Hau381/DC_Motor_Speed_And_Position_Control/baocao.pdf

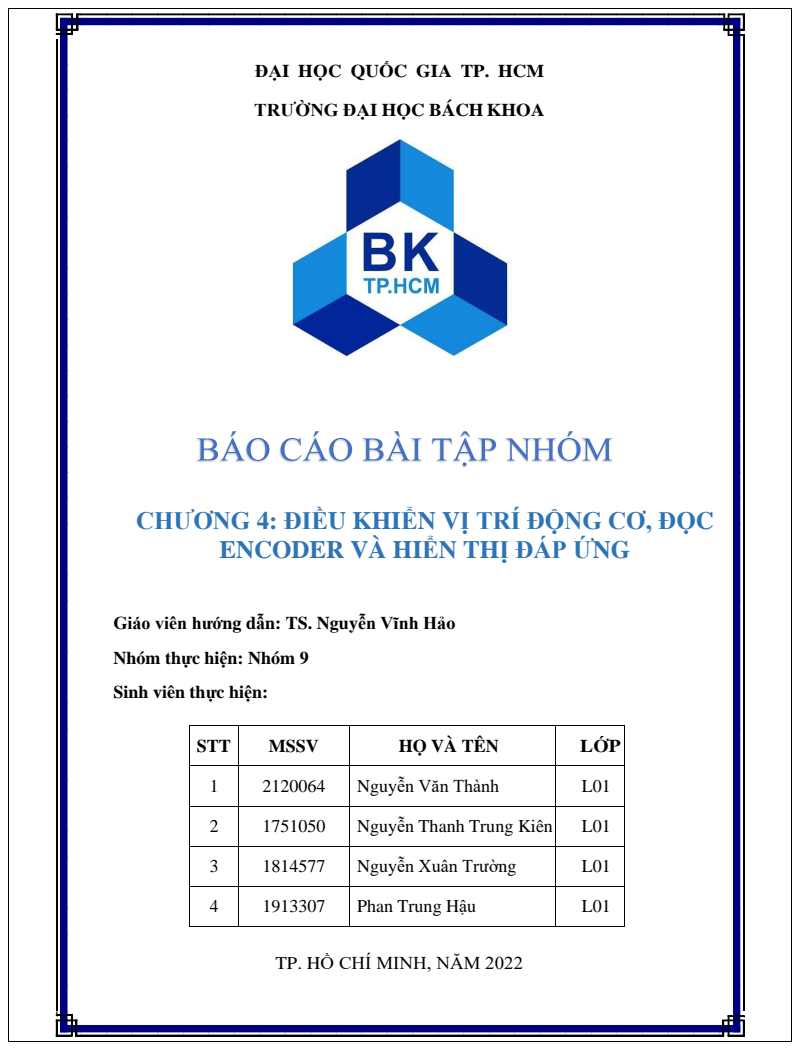
[picture p1: page 1]

ĐẠI HỌC QUỐC GIA TP. HCM

TRƯỜNG ĐẠI HỌC BÁCH KHOA

CHƯƠNG 4: ĐIỀU KHIỂN VỊ TRÍ ĐỘNG CƠ, ĐỌC

ENCODER VÀ HIỂN THỊ ĐÁP ỨNG

Giáo viên hướng dẫn: TS. Nguyễn Vĩnh Hảo

Nhóm thực hiện: Nhóm 9

Sinh viên thực hiện:

STT | MSSV | HỌ VÀ TÊN | LỚP

1 | 2120064 | Nguyễn Văn Thành | L01

2 | 1751050 | Nguyễn Thanh Trung Kiên | L01

3 | 1814577 | Nguyễn Xuân Trường | L01

4 | 1913307 | Phan Trung Hậu | L01

TP. HỒ CHÍ MINH, NĂM 2022

# Mục lục

### I. CHUẨN BỊ THIẾT BỊ VÀ LINH KIỆN

### 1.1 Động cơ Servo GM25 – 370 DC Geared Motor:

- Động Cơ DC Servo GM25-370 DC Geared Motor được tích hợp thêm Encoder hai kênh AB giúp đọc và điều kiển chính xác vị trí, chiều quay của động cơ trong các

ứng dụng cần độ có chính xác cao: điều khiển PID, Robot tự hành,....

- Động Cơ DC Servo GM25-370 DC Geared Motor có cấu tạo bằng kim loại cho độ

bền và độ ổn định cao, được sử dụng trong các mô hình robot, xe, thuyền,..., hộp

giảm tốc của động cơ có nhiều tỉ số truyền giúp bạn dễ dàng lựa chọn giữa lực kéo

và tốc độ (lực kéo càng lớn thì tốc độ càng chậm và ngược lại), động cơ sử dụng

nguyên liệu chất lượng cao.

- Thông số kỹ thuật:
- Điện áp sử dụng: 12VDC
- Đường kính: 25mm
- Encoder: Cảm biến từ trường Hall, có 2 kênh AB lệch nhau giúp xác định chiều

quay và vận tốc của động cơ, đĩa Encoder trả ra 11 xung/1 kênh/ 1 vòng (nếu đo

tín hiệu đồng thời của cả hai kênh sẽ thu được tổng 22 xung / 1 vòng quay của

Encoder).
- Cách tính số xung của mỗi kênh trên 1 vòng quay của trục chính động cơ = Tỉ số

truyền x số xung của Encoder, ví dụ tỉ số 150:1 thì số xung Encoder trả ra cho 1

vòng quay của trục chính động cơ sẽ là 11 x 150 = 1650 xung / 1 kênh.
- Điện áp cấp cho Encoder hoạt động: 3.3~5VDC, lưu ý cấp quá áp hoặc ngược chiều

sẽ làm cháy Encoder ngay lập tức!

Nhóm sử dụng Loại 12VDC 250RPM:
- Tỉ số truyền 34:1 (động cơ quay 34 vòng trục chính hộp giảm tốc quay 1

vòng).

- Dòng không tải: 150mA
- Dòng chịu đựng tối đa khi có tải: 750mA
- Tốc độ không tải: 250RPM (250 vòng 1 phút)
- Tốc độ chịu đựng tối đa khi có tải: 140RPM (140 vòng 1 phút)

- Lực kéo Moment định mức: 4.3KG.CM
- Lực léo Moment tối đa: 5.2KG.CM
- Chiều dài hộp số L: 21mm
- Số xung Encoder mỗi kênh trên 1 vòng quay trục chính: 11 x 34 = 374 xung.
- Sơ đồ chân của động cơ:
- M1 : Dây cấp nguồn cho động cơ.
- GND : Dây cấp nguồn cho Encoder, 0VDC.
- C1/A: Kênh trả xung A
- C2/B: Kênh trả xung B
- VCC: Dây cấp nguồn cho Encoder 3.3~5VDC
- M2: Dây cấp nguồn cho động cơ

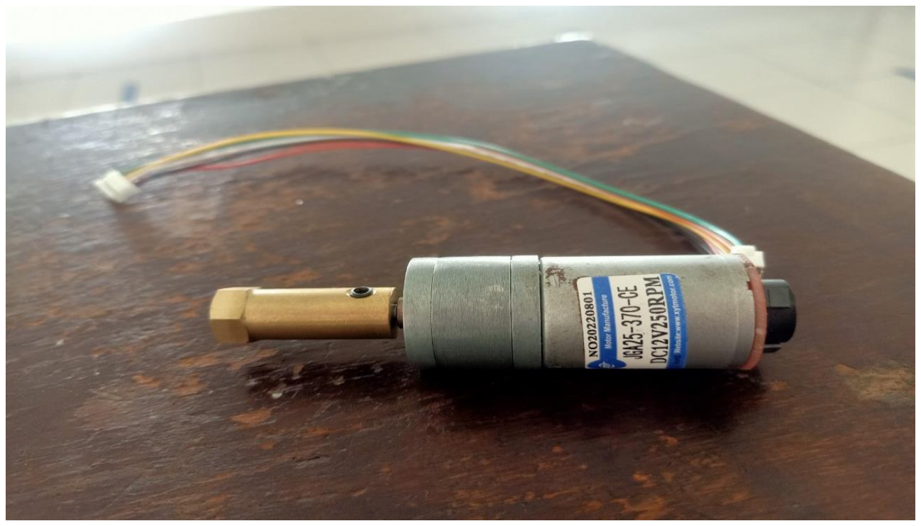
[picture p2: figure]

Hình 1: Động cơ 12VDC 250RPM

### 1.2 L298 DC Motor Driver

Module điều khiển motor L298N loại 1 có sẵn ốc gắn sử dụng IC điều khiển L298N có thể

điều khiển 2 động cơ một chiều hoặc 1 động cơ bước 4 pha.

Module L298N loại 1:

+ Được thiết kế chắc chắn, có sẵn chỗ bắt ốc vào mô hình

+ Có gắn tản nhiệt chống nóng cho IC, giúp IC có thể điều khiển với dòng đỉnh đạt 2A.

IC L298N được gắn với các đi ốt trên board giúp bảo vệ vi xử lý chống lại các dòng điện

cảm ứng từ việc khởi động/ tắt động cơ.

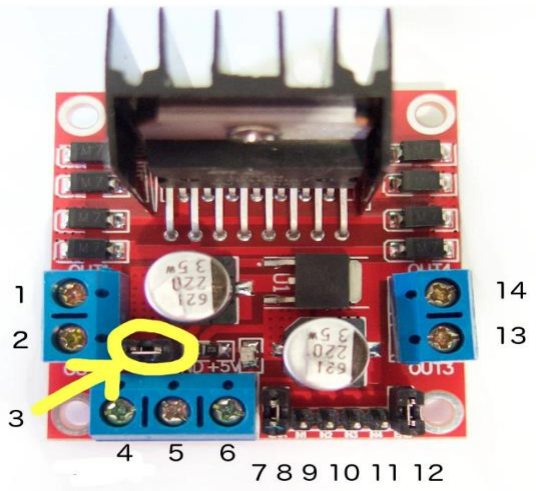
[picture p3: figure]

Hình 2: L298 DC Motor Driver

- Sơ đồ chân L298 DC Motor Driver
1. DC motor 1 “+” hoặc stepper motor A+
2. DC motor 1 “-” hoặc stepper motor A-
3. 12V jumper – tháo jumper ra nếu sử dụng nguồn trên 12V. Jumper này dùng để

cấp nguồn cho IC ổn áp tạo ra nguồn 5V nếu nguồn trên 12V sẽ làm cháy IC

Nguồn

4. Cắm dây nguồn cung cấp điện áp cho motor vào đây từ 6V đến 35V.
5. Cắm chân GND của nguồn vào đây
6. Ngõ ra nguồn 5V, nếu jumper đầu vào không rút ra.
7. Chân Enable của Motor 1, chân này dùng để cấp xung PWM cho motor nếu

dùng VDK thì rút jumper ra và cắm chân PWM vào đây. Giữ nguyên khi dùng với

động cơ bước

8. IN1
9. IN2
10. IN3
11. IN4
12. Chân Enable của Motor 2, chân này dùng để cấp xung PWM cho motor nếu

dùng VDK thì rút jumper ra và cắm chân PWM vào đây. Giữ nguyên khi dùng với

động cơ bước

13. DC motor 2 “+” hoặc stepper motor B+
14. DC motor 2 “-” hoặc stepper motor B-

### 1.3 Nguồn Adapter 12VDC 2A

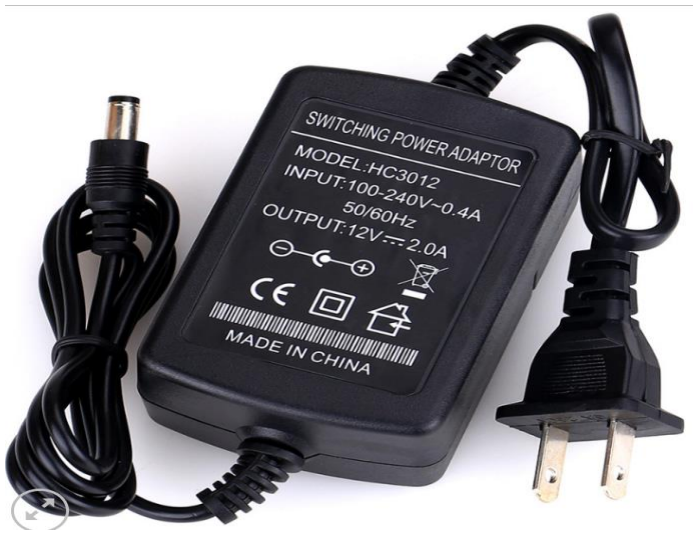
[picture p4: figure]

Hình 3 Nguồn Adapter 12VDC 2A

Thông số kỹ thuật

- Điện áp đầu vào: AC100-240V 50/60HZ
- Đầu cắm AC
- Điện áp ra: 12VDC
- Dòng điện ra: Max 2A
- Chiều dài đường dây đầu ra: tổng chiều dài 1m
- Ổ cắm DC: 5.5 * 2.5mm (tương thích 5.5 * 2.1mm)
- Trọng lượng: 92g

### 1.4 USB Uart CH340

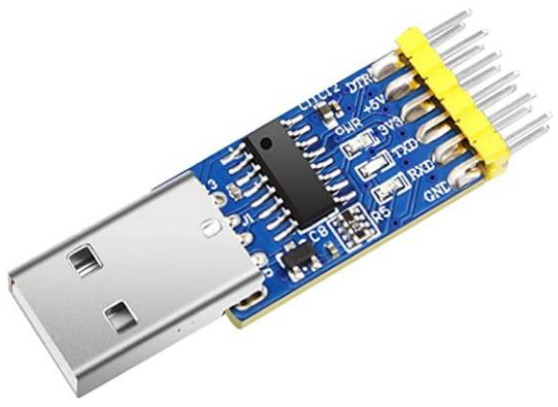
[picture p5: figure]

Hình 4: USB Uart CH340

Thông số kỹ thuật:

- Sử dụng điện áp 5VDC cấp trực tiếp từ cổng USB.
- Các chân tín hiệu ngõ ra:
- 5V: Chân cấp nguồn 5VDC từ cổng USB, tối đa 500mA.
- VCC: chân chọn mức tín hiệu TTL cho TX/RX, nếu nối với chân 5V sẽ là 5VDC,

nối với 3V3 sẽ là 3.3VDC.

- 3V3:Chân nguồn 3.3VDC (dòng cấp rất nhỏ tối đa 100mA), không sử dụng để cấp

nguồn, thường chỉ sử dụng để thiết đặt mức tín hiệu Logic.

- TXD: chân truyền dữ liệu UART TTL, dùng kết nối đến chân nhận RX của các

module sử dụng mức tín hiệu TTL.
- RXD: chân nhận dữ liệu UART TTL, dùng kết nối đến chân nhận TX của các

module sử dụng mức tín hiệu TTL.
- GND: chân cấp nguồn 0VDC.
- Tích hợp led tín hiệu TX, RX.
- Tương thích với hầu hết các hệ điều hành hiện nay: Windows, Mac, Linux.

### 1.5 Kit STM32F407

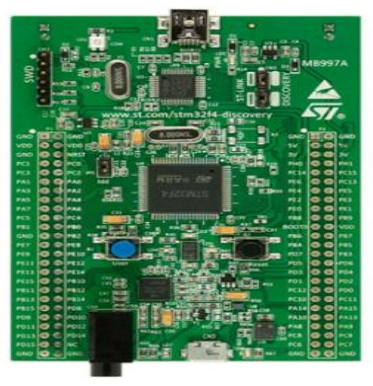
[picture p6: figure]

Hình 5: Kit STM32F407

- Kit STM32F407 Discovery hiện là loại kit được rất nhiều trường đại học hiện nay

sử dụng trong giảng dạy vi điều khiển ARM, nếu so sánh về ngoại vi và sức mạnh

của STM32 so với các dòng ARM của các hãng khác thì ở cùng 1 tầm giá, ARM

của ST vượt trội về cấu hình và ngoại vi hơn rất nhiều.

Thông số kỹ thuật:

- Vi điều khiển chính: STM32F407VGT6 microcontroller featuring 32-bit ARM

Cortex-M4F core, 1 MB Flash, 192 KB RAM in an LQFP100 package.
- Tích hợp sẵn mạch nạp và Debug ST-LINK/V2 with selection mode switch to use

the kit as a standalone ST-LINK/V2 (with SWD connector for programming and

debugging).
- Nguồn cấp từ cổng Mini USB qua các IC nguồn chuyển thành 3v3 để cấp cho MCU.
- Có sẵn các chân nguồn: 3 V and 5 V.

- Có sẵn cảm biến gia tốc: LIS302DL, ST MEMS motion sensor, 3-axis
- Có sẵn bộ xử lý âm thanh: MP45DT02, ST MEMS audio sensor, omni-directional

digital microphone.
- Có sẵn bộ: CS43L22, audio DAC with integrated class D speaker driver.
- Có sẵn 8 Led.
- Có Led thông báo trạng thái nguồn
- Có nút nhấn và nút Reset tích hợp.
- Có cổng Micro USB OTG
- DSP Application.

### II. SƠ ĐỒ KẾT NỐI CHÂN VÀ NGUYÊN LÝ HOẠT ĐỘNG

### 2.1 Sơ đồ kết nối chân

- Nhóm sử dụng phần mềm Altium Designer để thiết kế mạch Schematic và vẽ

mạch in PCB để làm mạch phần cứng.

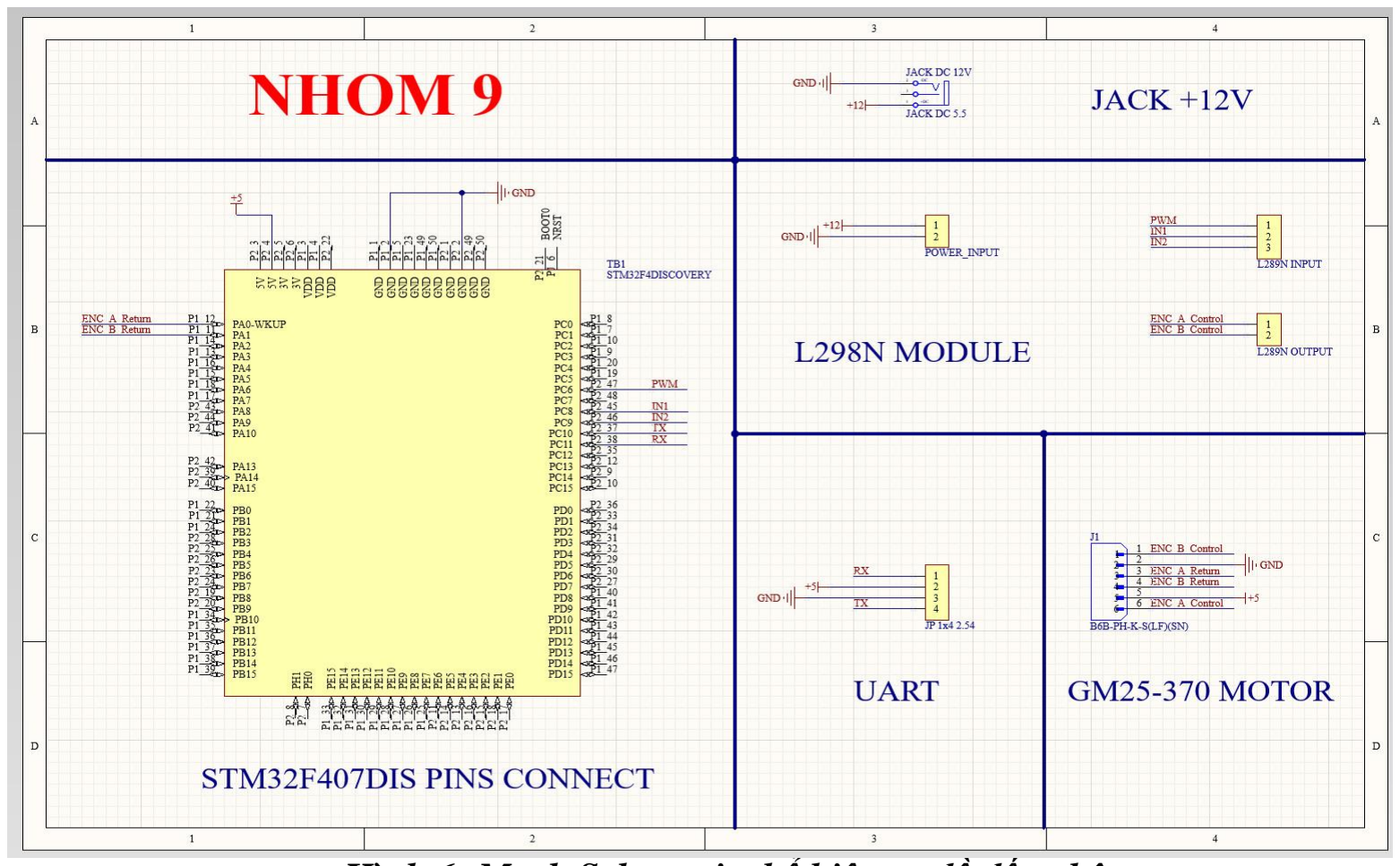
[picture p7: figure]

Hình 6: Mạch Schematic thể hiện sơ đồ đấu chân

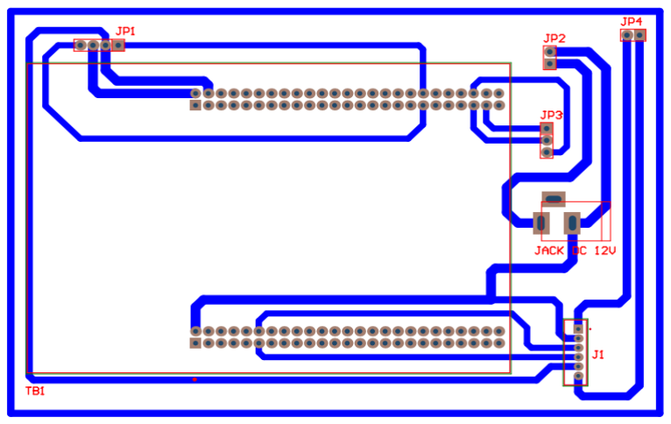
[picture p8: figure]

Hình 7: Mạch in PCB

Qúa trình chọn chân đấu nối:

- Đọc encoder sử dụng port A:

+PA0: ENC A

+ PA1: ENC B
- Giao tiếp UART: Sử dụng port C giao tiếp UART4:

+PC10: UART TX

+PC11: UART RX
- Điều rộng xung PWM và quy định chiều quay motor:

+ PC6: PWM

+PC8: IN1

+PC9: IN2

### 2.2 Nguyên lý hoạt động

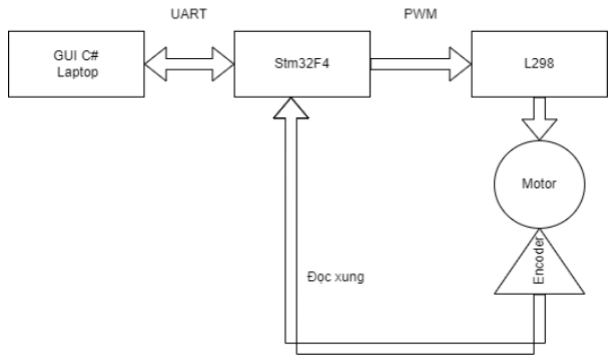
[picture p9: figure]

Hình 8: Sơ đồ nguyên lý

+ Nhóm sẽ viết dao diện bằng C# để đọc và xuất UART và vẽ đáp ứng hiện thị vị trí động cơ

dưới dạng góc quay.

+ STM32F4: đọc xung encoder 2 kênh A,B theo 2 mode là X1 và X4. Điều rộng xung PWM để

điều khiển động cơ.

+ L298 điểu khiển động cơ thông qua việc thay đổi điện áp cấp vào động cơ qua 2 chân out1 và

out2.

+ Motor hoạt động: trục chính motor quay được bao nhiêu vòng thì sẽ xuất được bấy nhiêu xung

ENC A và ENC B ( với 1 vòng là 374 xung). Rồi trả xung về Stm32f4 để đọc xung theo mode

đã chọn và hiển thị đáp ứng lên giao diện C# đã tạo.

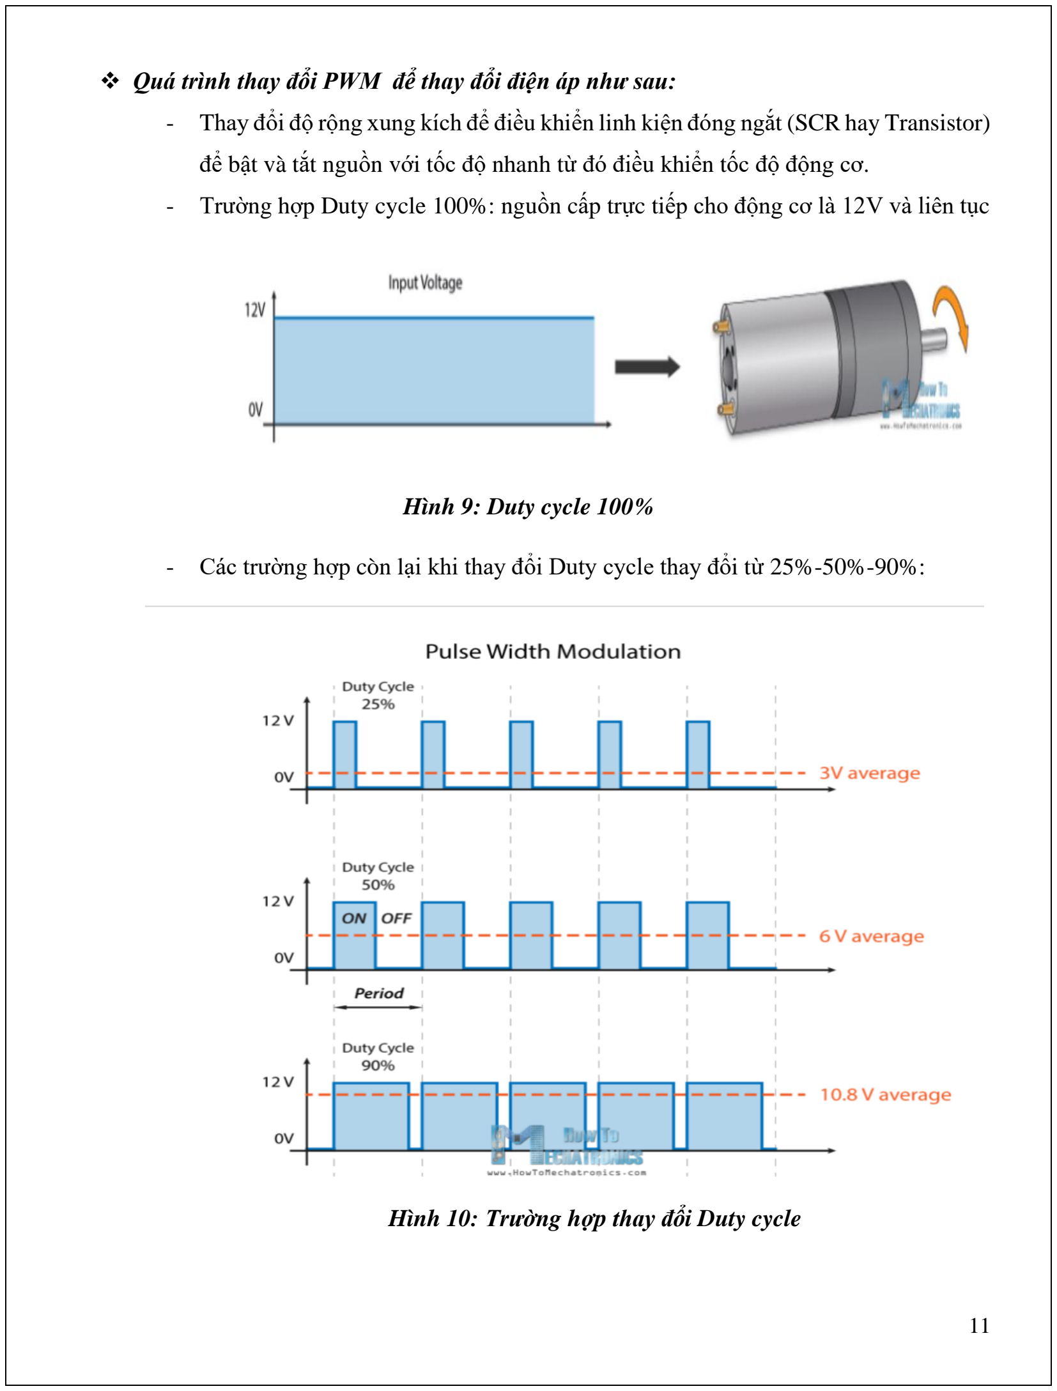
[picture p10: page 13]

❖ Quá trình thay đổi PWM để thay đổi điện áp như sau:

- Thay đổi độ rộng xung kích để điều khiển linh kiện đóng ngắt (SCR hay Transistor)

để bật và tắt nguồn với tốc độ nhanh từ đó điều khiển tốc độ động cơ.

- Trường hợp Duty cycle 100%: nguồn cấp trực tiếp cho động cơ là 12V và liên tục

Hình 9: Duty cycle 100%

- Các trường hợp còn lại khi thay đổi Duty cycle thay đổi từ 25%-50%-90%:

Hình 10: Trường hợp thay đổi Duty cycle

- Khi Duty cycle càng lớn thì điện áp trung bình cấp cho động cơ cào lớn, động cơ

quay càng nhanh.

❖ Thay đổi chiều quay động cơ thông qua 2 chân IN1 và IN2:

- Để điều khiển hướng quay, chúng ta chỉ cần đảo ngược hướng của dòng điện qua

động cơ, và phương pháp phổ biến nhất để làm điều đó là sử dụng mạch cầu H.

Một mạch cầu H chứa bốn chân chuyển mạch, điện trở hoặc MOSFET, với động

cơ ở trung tâm tạo thành một cấu hình giống như chữ H. Bằng cách kích hoạt hai

công tắc cụ thể cùng một lúc, chúng ta có thể thay đổi hướng của dòng điện, do đó

thay đổi hướng quay của động cơ.

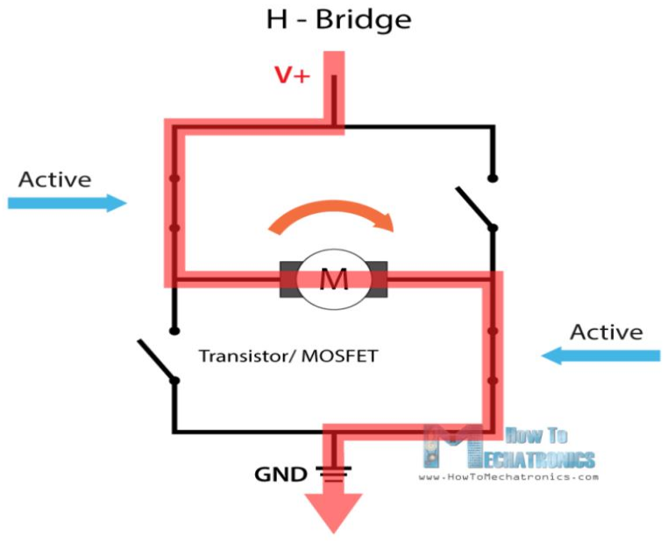
[picture p11: figure]

Hình 11: Thay đổi chiều quay động cơ

### III. VIẾT CHƯƠNG TRÌNH

### 3.1 Lưu đồ giải thuật để viết code trong Keil uVision 5

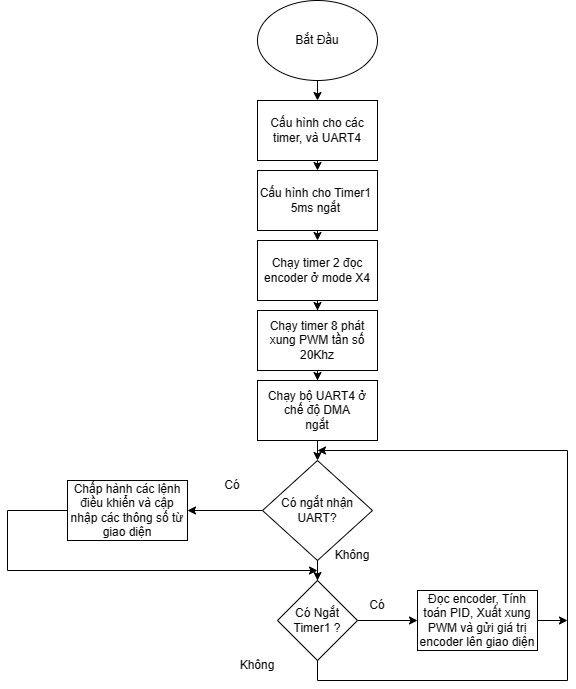
[picture p12: figure]
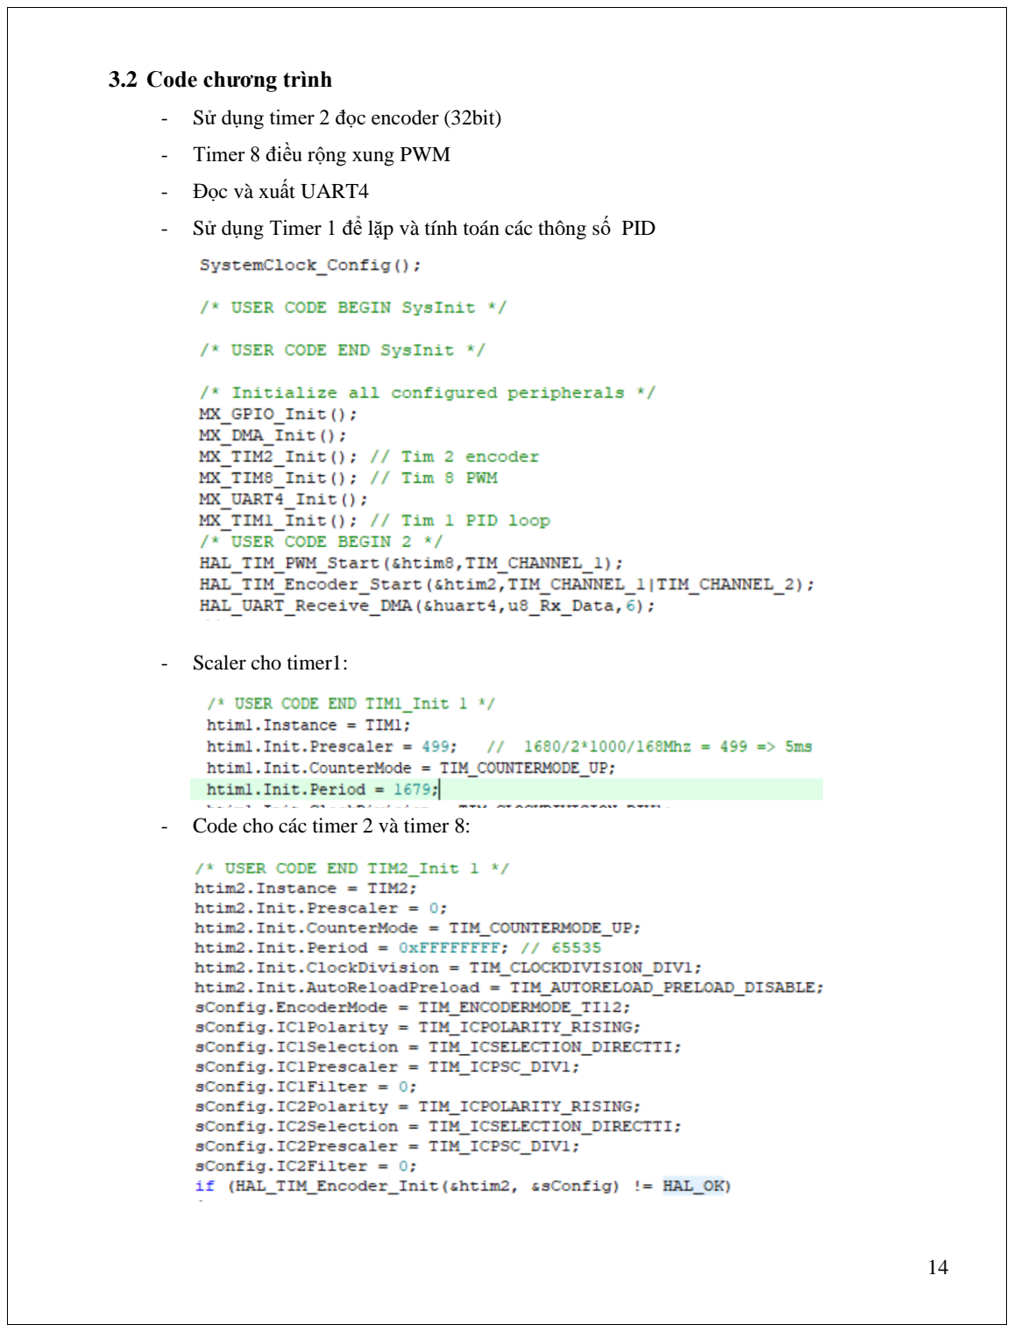
[picture p13: page 16]

### 3.2 Code chương trình

- Sử dụng timer 2 đọc encoder (32bit)
- Timer 8 điều rộng xung PWM
- Đọc và xuất UART4
- Sử dụng Timer 1 để lặp và tính toán các thông số PID
- Scaler cho timer1:
- Code cho các timer 2 và timer 8:

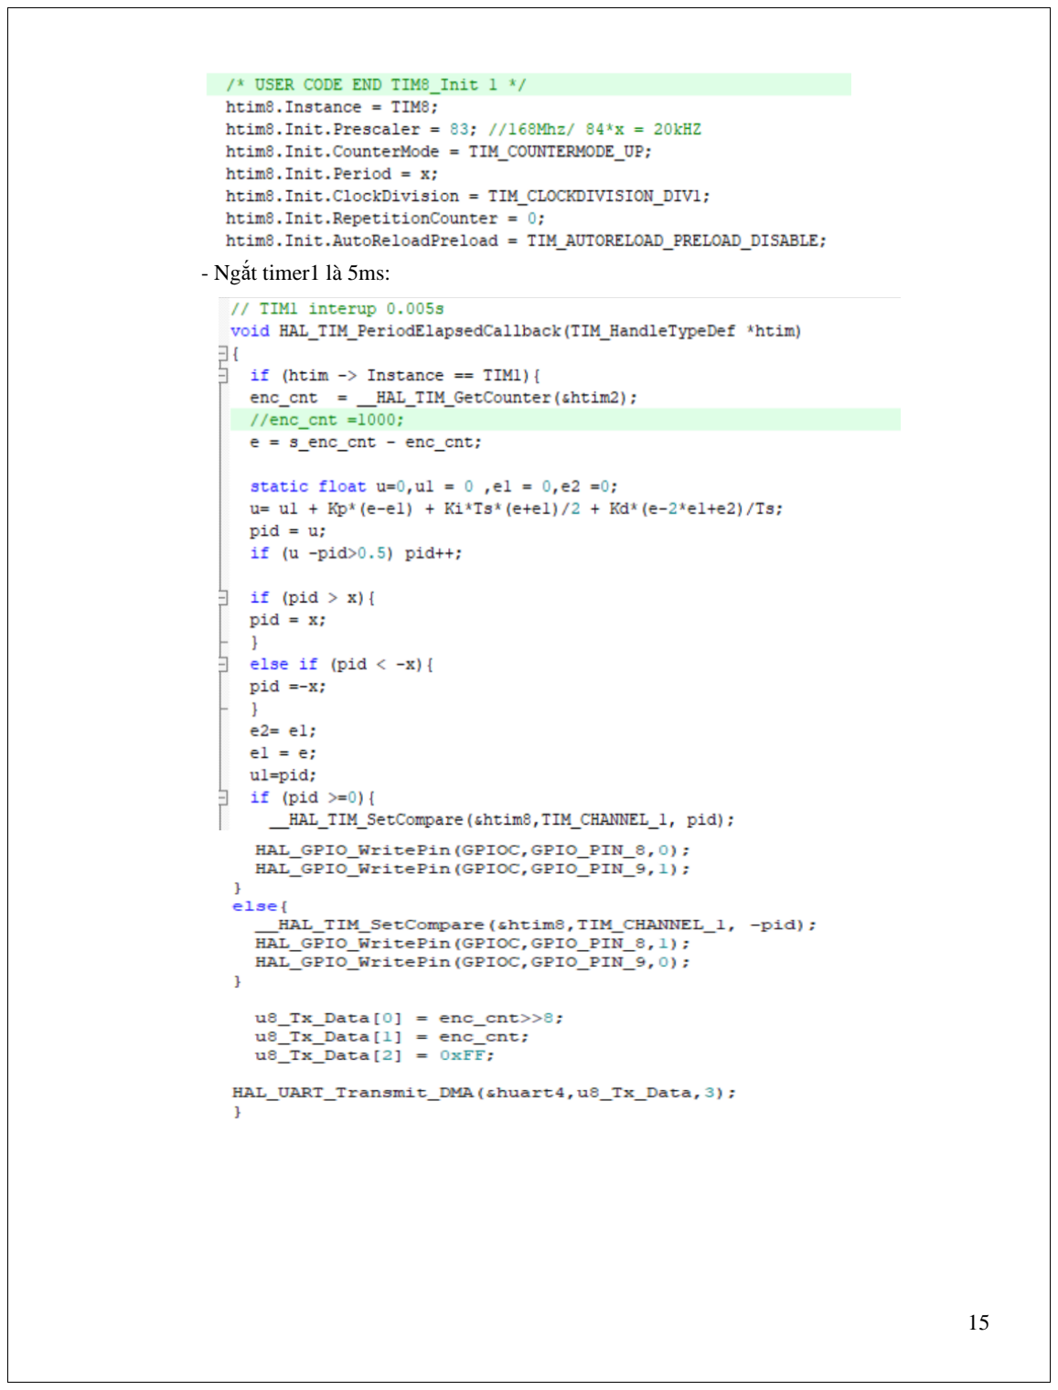
[picture p14: page 17]

- Ngắt timer1 là 5ms:

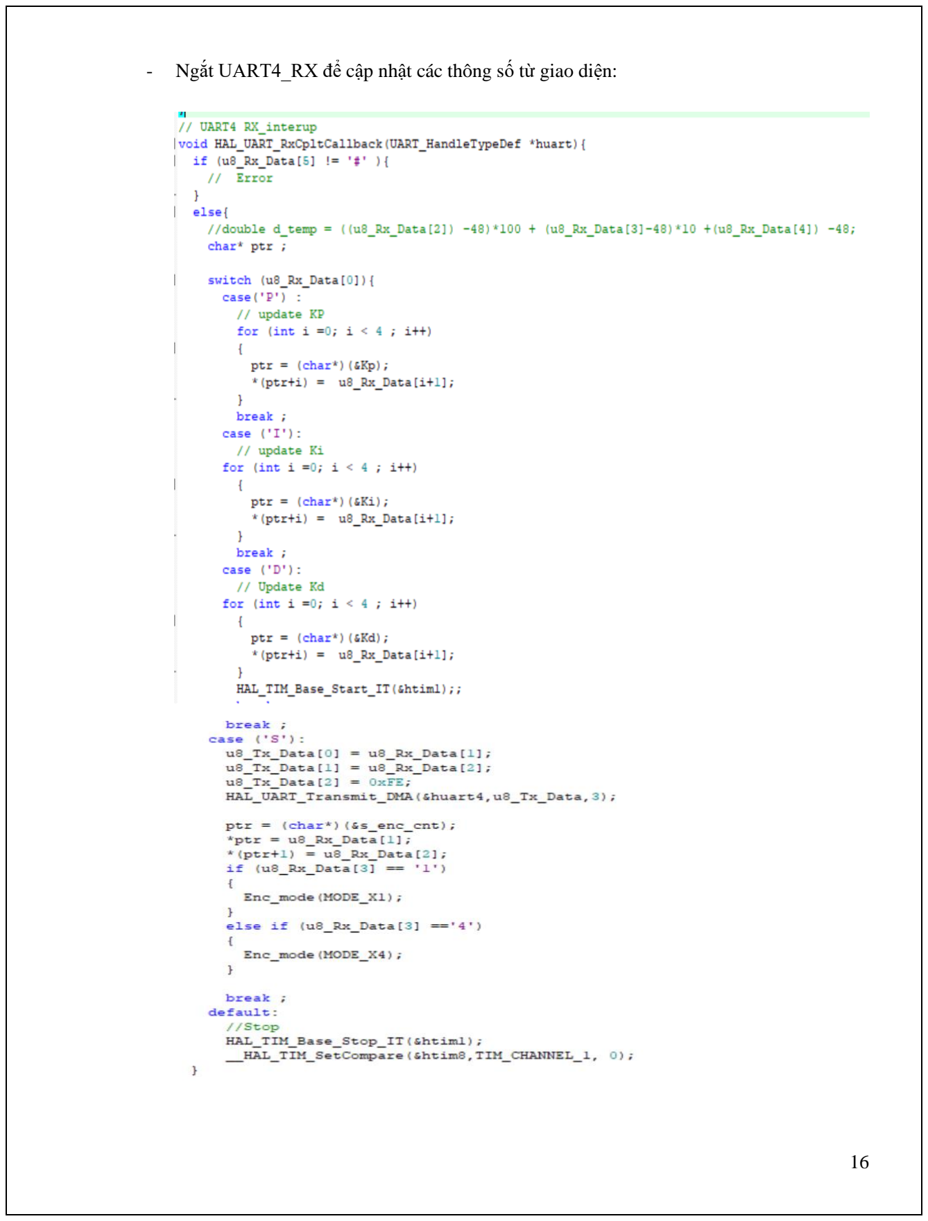
[picture p15: page 18]

- Ngắt UART4_RX để cập nhật các thông số từ giao diện:

3.3Lưu đồ giải thuật code C#

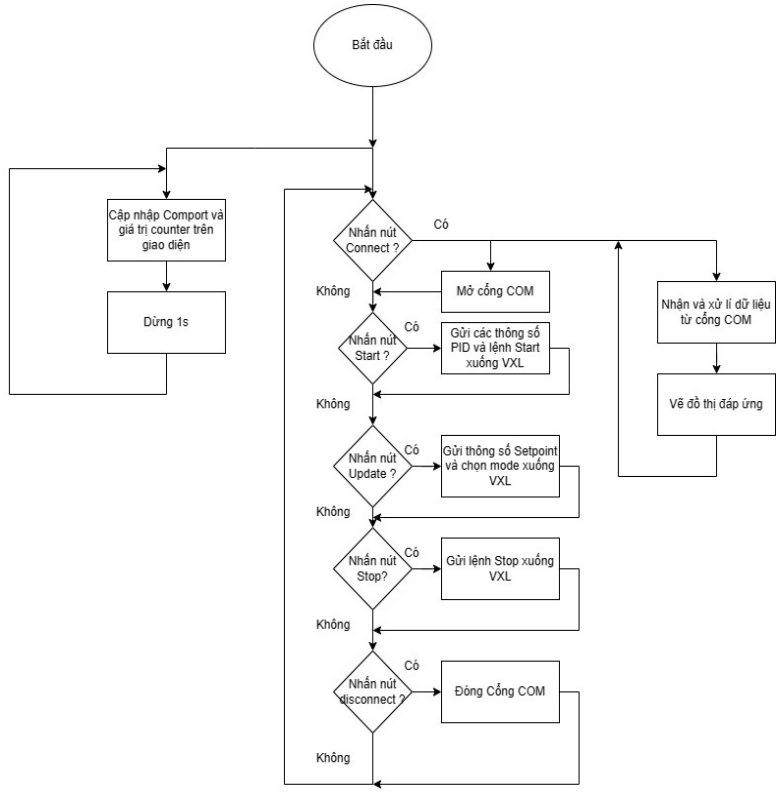
[picture p16: figure]
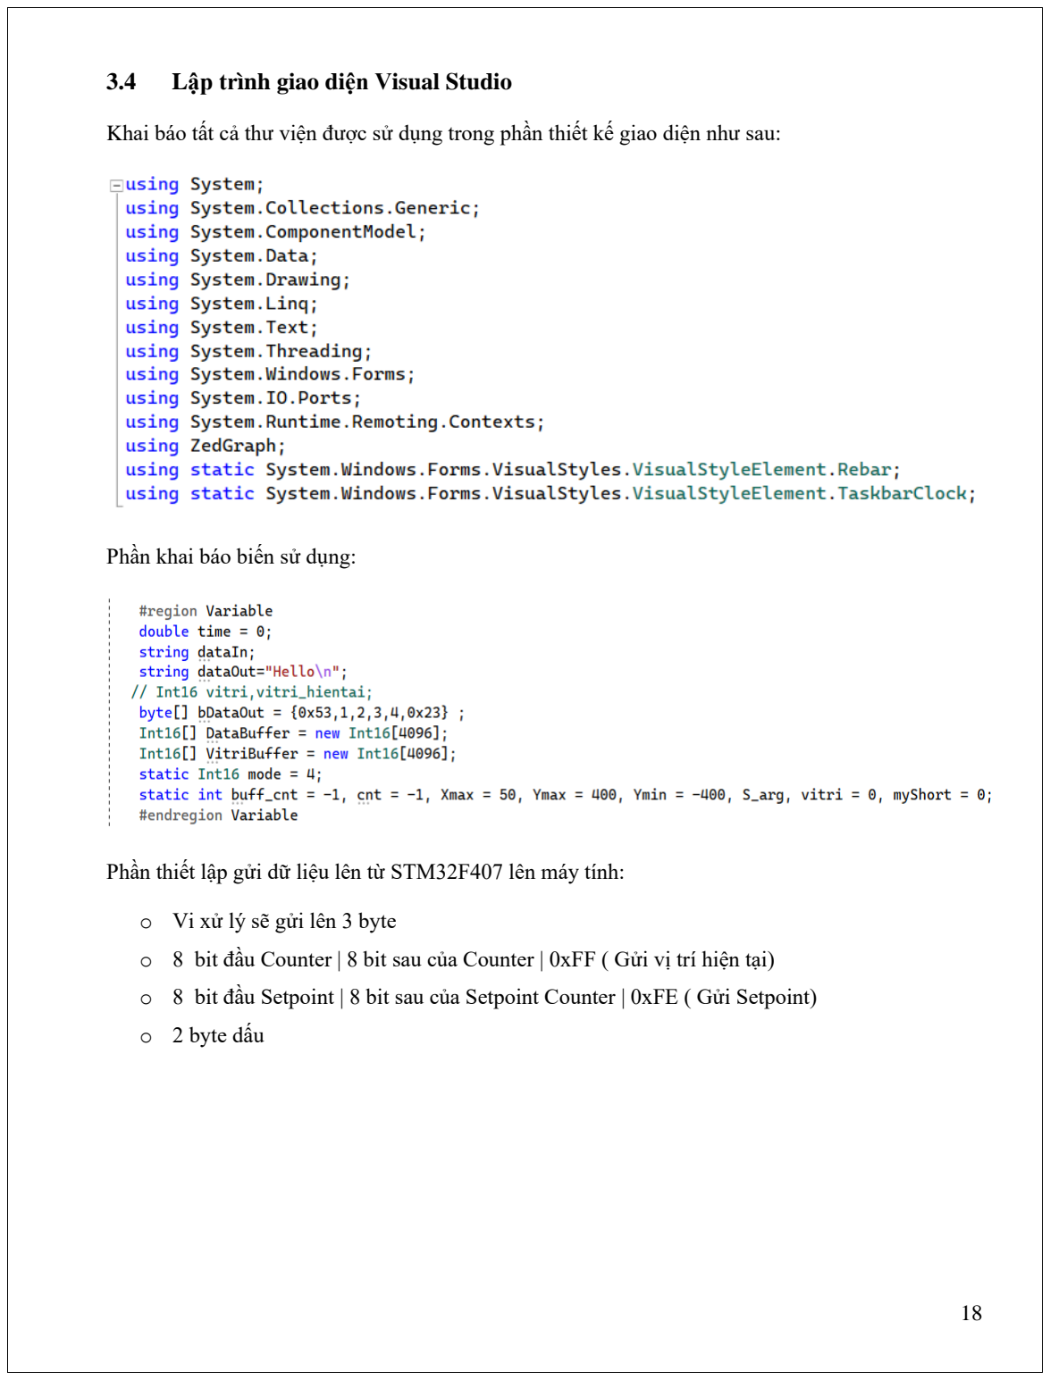
[picture p17: page 20]

### 3.4 Lập trình giao diện Visual Studio

Khai báo tất cả thư viện được sử dụng trong phần thiết kế giao diện như sau:

Phần khai báo biến sử dụng:

Phần thiết lập gửi dữ liệu lên từ STM32F407 lên máy tính:

- Vi xử lý sẽ gửi lên 3 byte
- 8 bit đầu Counter | 8 bit sau của Counter | 0xFF ( Gửi vị trí hiện tại)
- 8 bit đầu Setpoint | 8 bit sau của Setpoint Counter | 0xFE ( Gửi Setpoint)
- 2 byte dấu

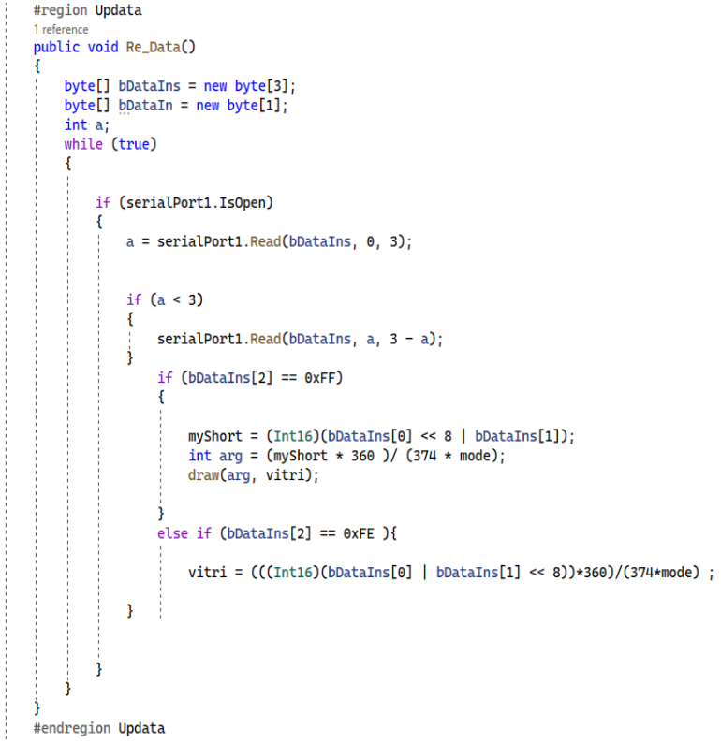
[picture p18: figure]

Thiết hàm Update để cập nhật dữ liệu xuống STM32F407

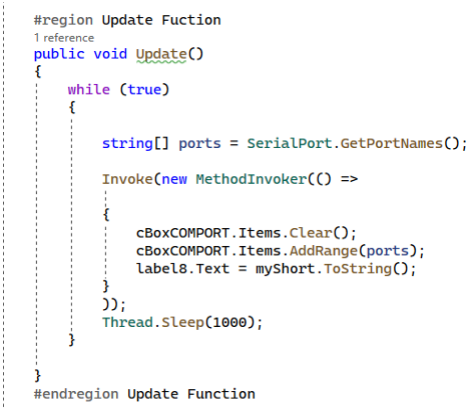
[picture p19: figure]

Thiết lập vẽ biểu đồ bằng Zedgraph trên Visual Studio và Realtime

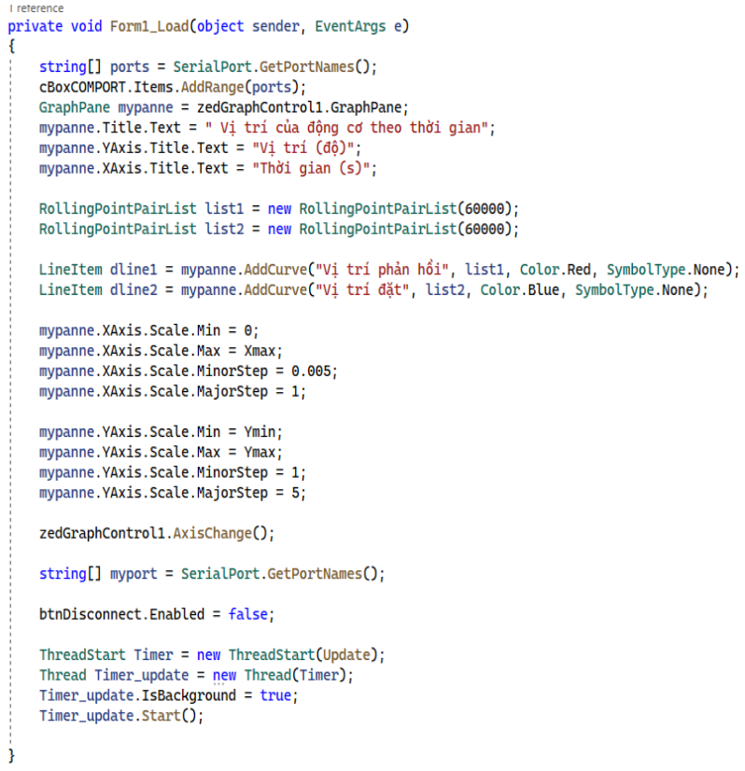
[picture p20: figure]

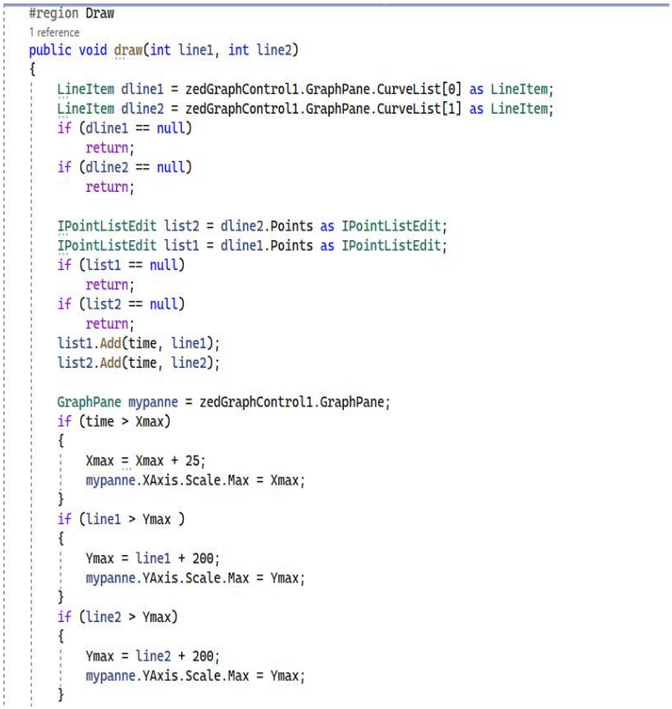
[picture p21: figure]
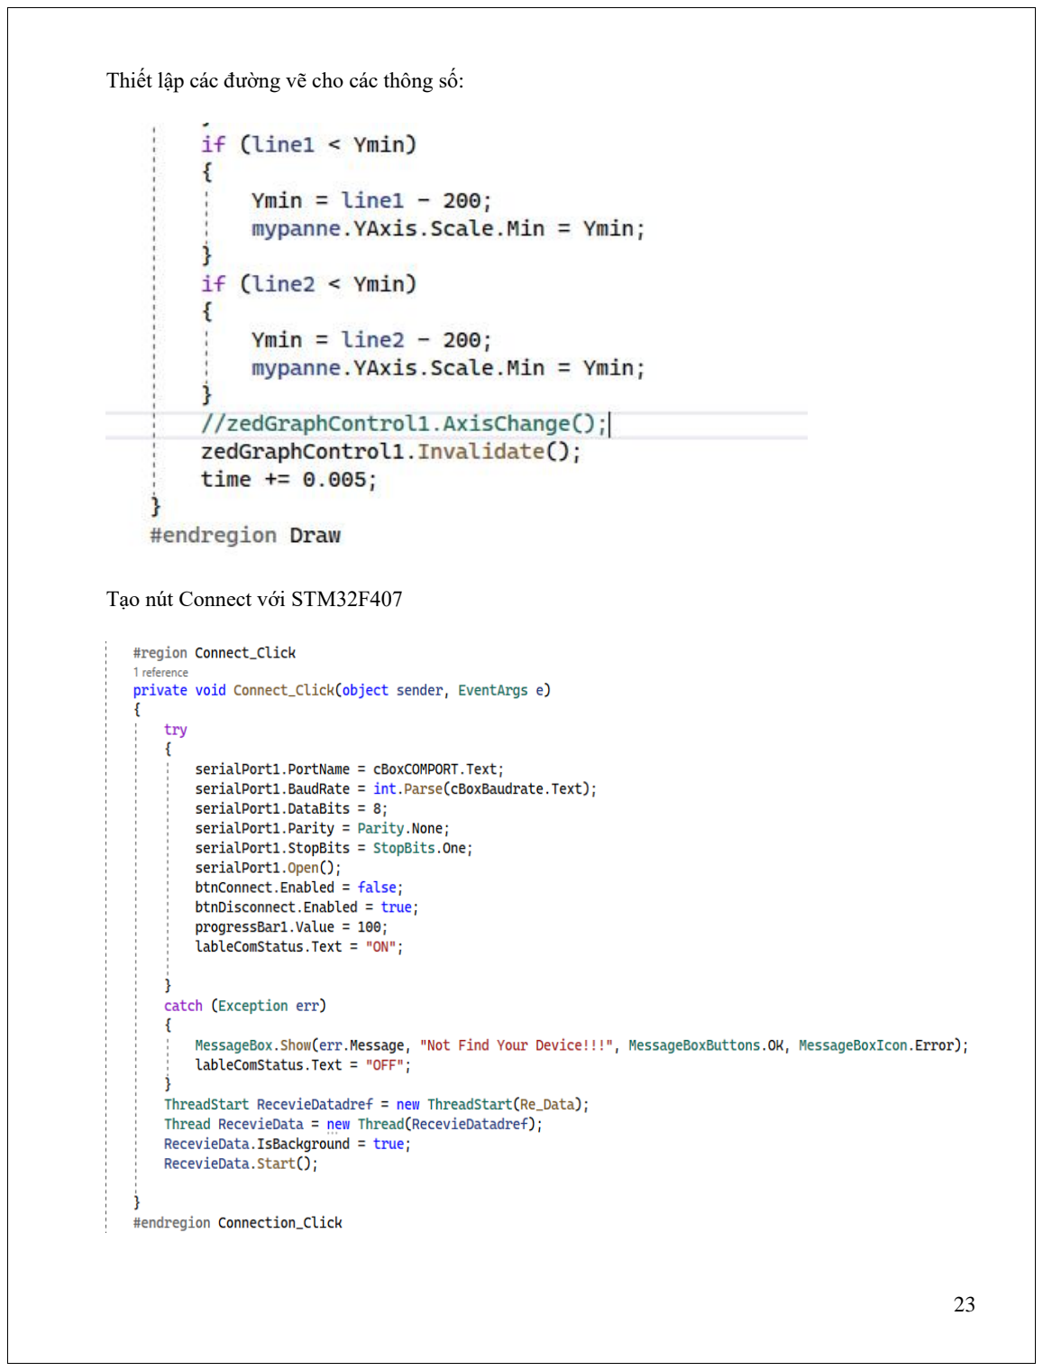
[picture p22: page 25]

Thiết lập các đường vẽ cho các thông số:

Tạo nút Connect với STM32F407

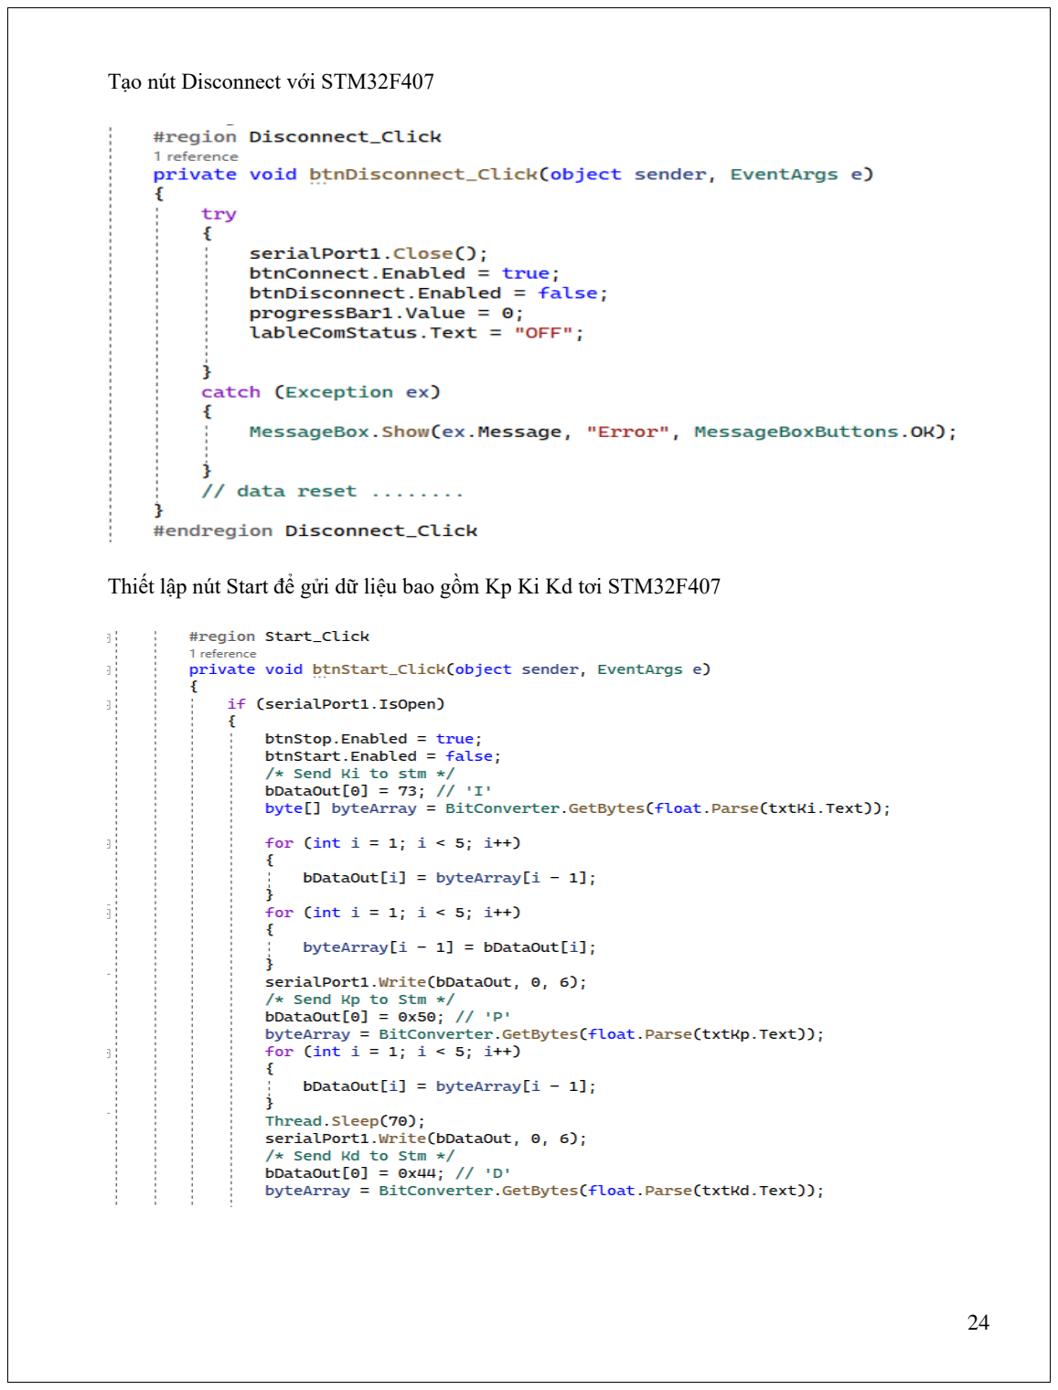
[picture p23: page 26]

Tạo nút Disconnect với STM32F407

Thiết lập nút Start để gửi dữ liệu bao gồm Kp Ki Kd tơi STM32F407

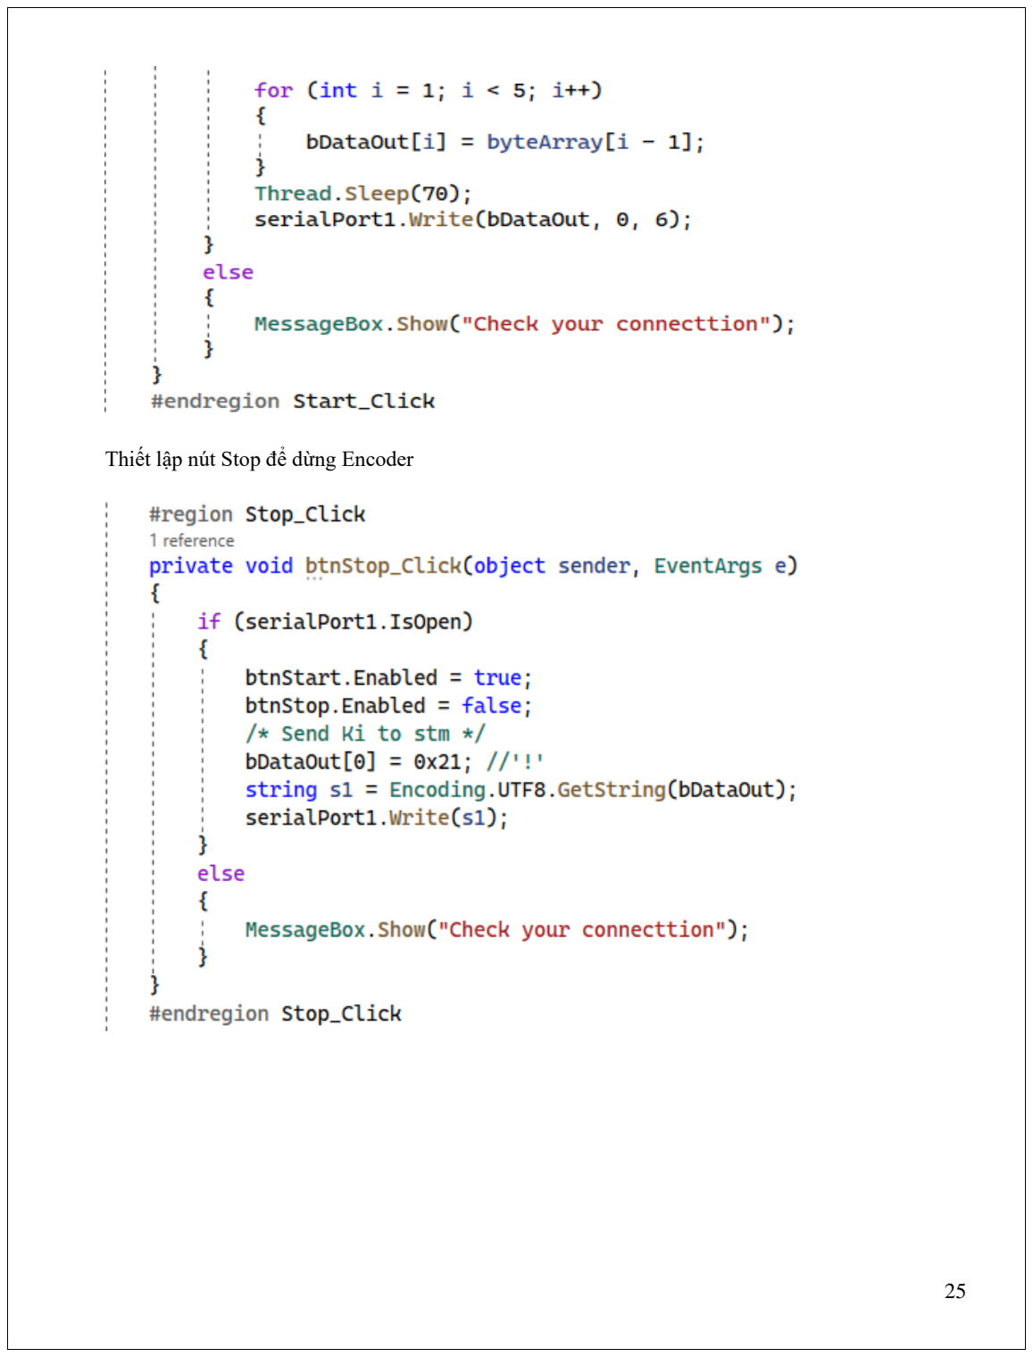
[picture p24: page 27]

Thiết lập nút Stop để dừng Encoder

Thiết lập nút Update để cập nhật dữ liệu được truyền xuống STM32F407

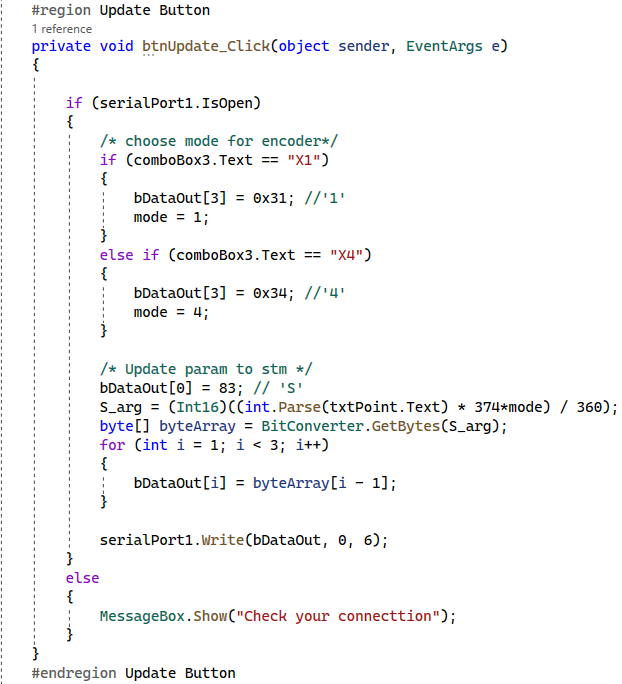
[picture p25: figure]
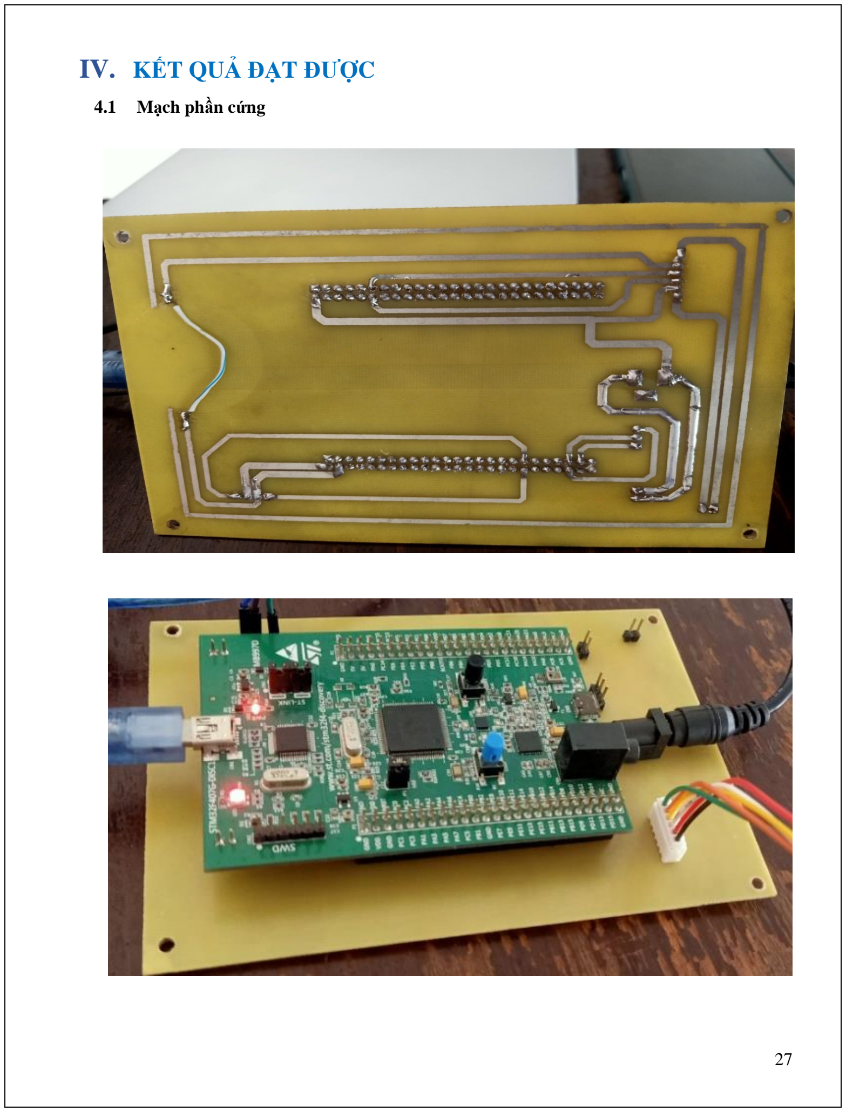
[picture p26: page 29]

### IV. KẾT QUẢ ĐẠT ĐƯỢC

### 4.1 Mạch phần cứng

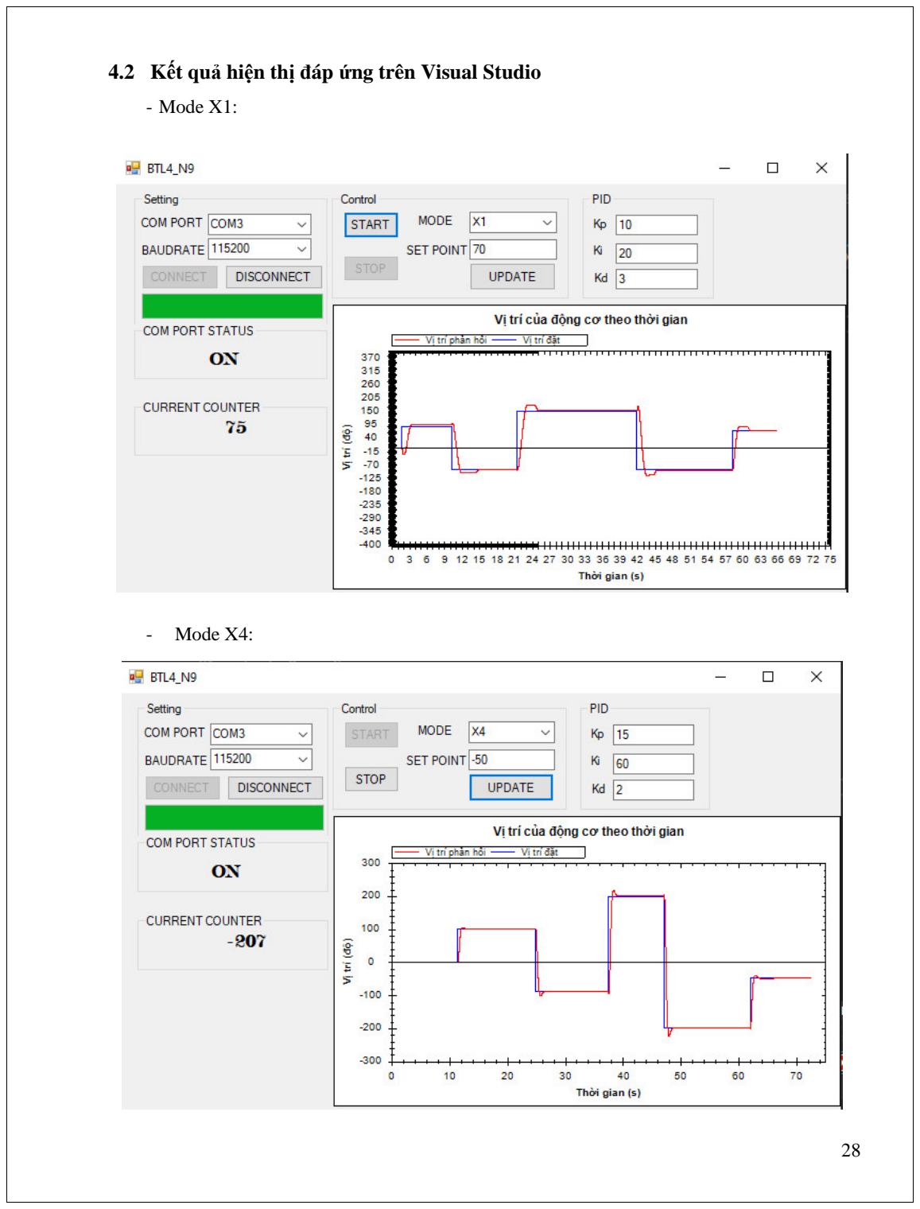
[picture p27: page 30]

### 4.2 Kết quả hiện thị đáp ứng trên Visual Studio

- Mode X1:
- Mode X4:

- Nhận xét: Mode X4 sẽ cho hiện thị đáp ứng vị trí của động cơ tốt hơn Mode X1, sai số

nhỏ và độ vọt lố thấp. Đường vị trí phản hồi từ động cơ bám sát với vị trí đặt cho trước

hơn.
