Hau381/DC_Motor_Speed_And_Position_Control/Gui_update.jpg

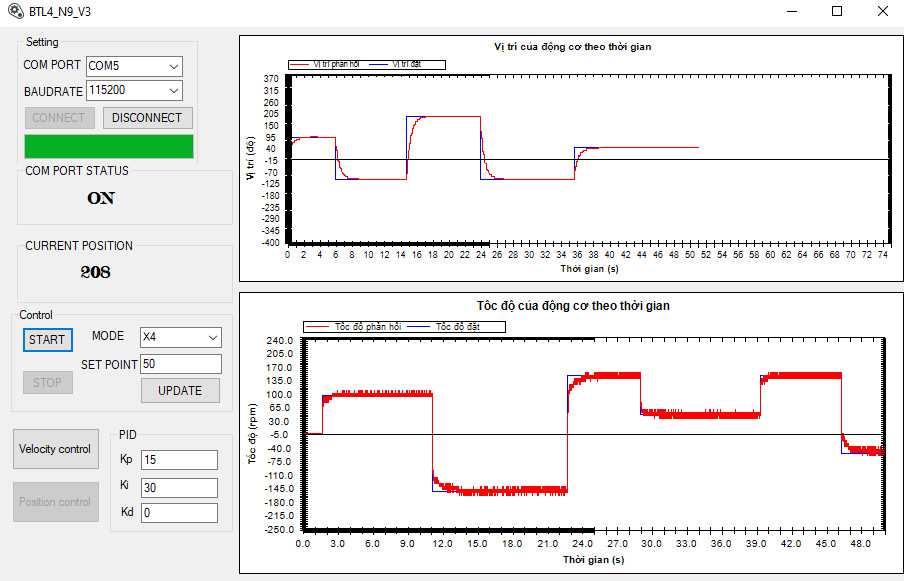
Gui_update.jpg
