Hau381/DC_Motor_Speed_And_Position_Control/Schematic/schematic.pdf

NHOM 9 | JACK +12V

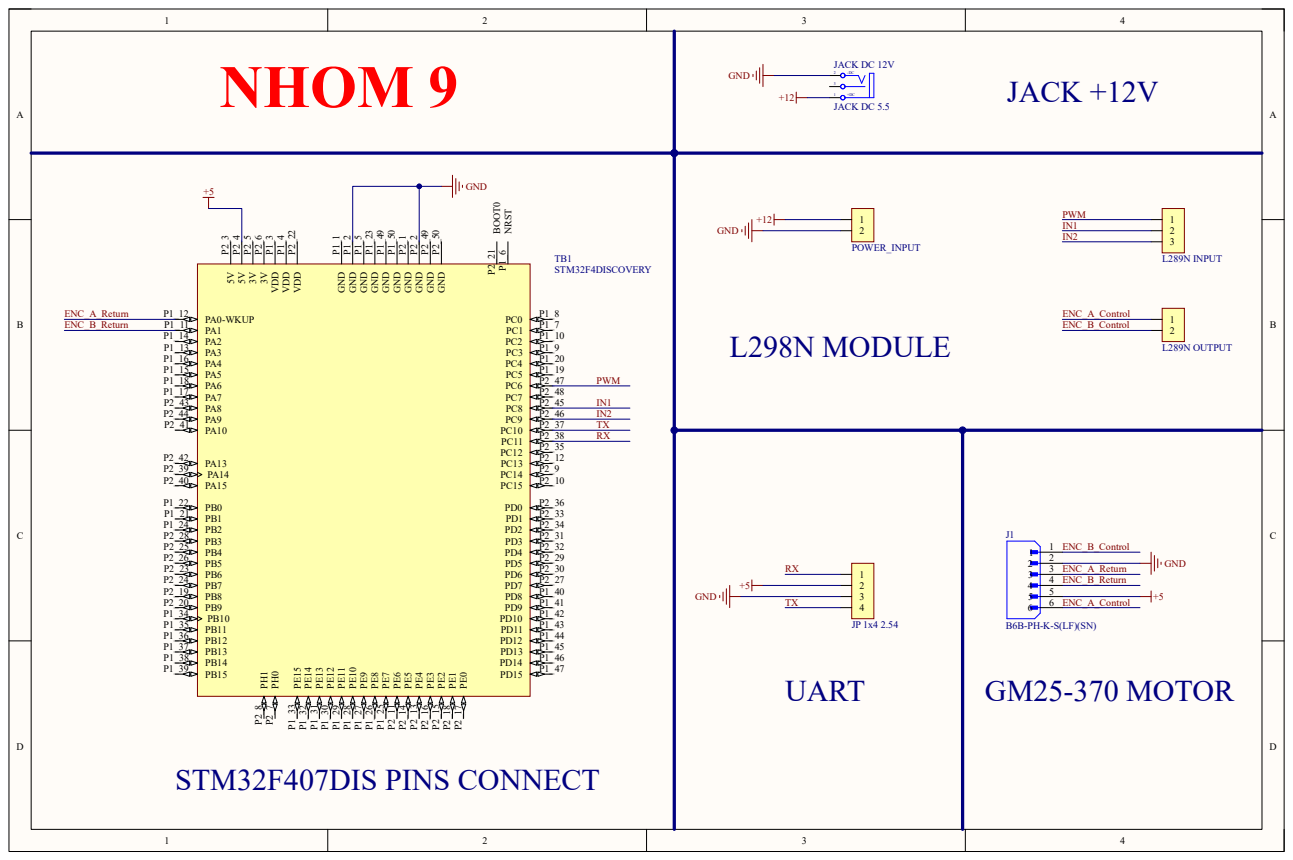
[picture p29: page 1]
ENC_A_Return ENC_B_Return; PWM; IN1 BOOT⁰ P²_21 NRST P¹_6; PA0-WKUP P1_12 PA1 P1_11 PA2 P1_14 PA3 P1_13 PA4 P1_16 PA5 P1_15 PA6 P1_18 PA7 P1_17 PA8 P2_43 PA9 P2_44 PA10 P2_41; P2_10 ⁵V P²_3 5V P²_4 3V P²_5 3V P²_6 VDD P¹_3 VDD P¹_4 VDD P²_22; P1_47 PE⁰ P²_17 PE¹ P²_18 PE² P²_15 PE³ P²_16 PE⁴ P²_13 PE⁵ P²_14 PE⁶ P²_11 PE⁷ P¹_25 PE⁸ P¹_26 PE⁹ P¹_27 PE¹⁰ P¹_28 PE¹¹ P¹_29 PE¹² P¹_30 PE¹³ P¹_31 PE¹⁴ P¹_32 PE¹⁵ P¹_33 PH⁰ P²_7 PH¹ P²_8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
