Hau381/DC_Motor_Speed_And_Position_Control/Schematic/footprint.pdf

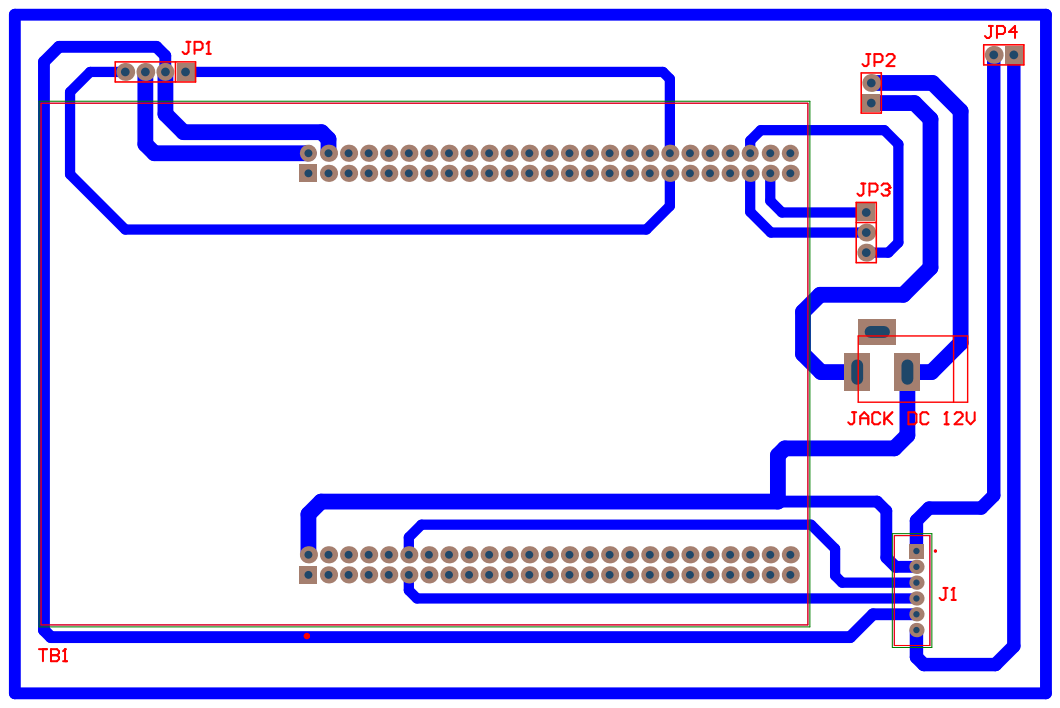
[picture p30: page 1]
