Hau381/DC_Motor_Speed_And_Position_Control/Stm32F4_Speed_And_Position_Control/Core/Src/main.c

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
/* Includes ------------------------------------------------------------------*/
#include "main.h"

/* USER CODE BEGIN PD */
#define MODE_X4 1
#define MODE_X1 0
#define MODE_V 0
#define MODE_P 1
/* USER CODE END PD */

TIM_HandleTypeDef htim1;
TIM_HandleTypeDef htim2;
TIM_HandleTypeDef htim8;

UART_HandleTypeDef huart4;
DMA_HandleTypeDef hdma_uart4_rx;
DMA_HandleTypeDef hdma_uart4_tx;

/* USER CODE BEGIN PV */
uint8_t u8_Rx_Data[6],u8_Tx_Data[3] , status = MODE_X4, test, state , mode = MODE_V;
int16_t enc_cnt =0,enc_cnt_pre =0, s_enc_cnt =0,e,pid,rate,s_rate,pulse1,pid1,Kp1=10,Ki1,Kd1; 
float Kp =10, Ki=10,Kd=0,Ts=0.005;
uint16_t x = 999; 


/* USER CODE END PV */

void SystemClock_Config(void);
static void MX_GPIO_Init(void);
static void MX_DMA_Init(void);
static void MX_TIM2_Init(void);
static void MX_TIM8_Init(void);
static void MX_UART4_Init(void);
static void MX_TIM1_Init(void);
/* USER CODE BEGIN PFP */
void HAL_TIM_PeriodElapsedCallback(TIM_HandleTypeDef *htim);
void HAL_UART_RxCpltCallback(UART_HandleTypeDef *huart);
void Enc_mode(uint8_t mode);
/* USER CODE END PFP */

/**
  * @brief  The application entry point.
  * @retval int
  */
int main(void)
{
  /* MCU Configuration--------------------------------------------------------*/

  /* Reset of all peripherals, Initializes the Flash interface and the Systick. */
  HAL_Init();

  /* Configure the system clock */
  SystemClock_Config();

  /* Initialize all configured peripherals */
  MX_GPIO_Init();
  MX_DMA_Init();
  MX_TIM2_Init(); // Tim 2 encoder
  MX_TIM8_Init(); // Tim 8 PWM
  MX_UART4_Init();
  MX_TIM1_Init(); // Tim 1 PID loop
  /* USER CODE BEGIN 2 */
	HAL_TIM_PWM_Start(&htim8,TIM_CHANNEL_1); 
	HAL_TIM_Encoder_Start(&htim2,TIM_CHANNEL_1|TIM_CHANNEL_2);
	//HAL_TIM_Base_Start_IT(&htim1);
	HAL_UART_Receive_DMA(&huart4,u8_Rx_Data,6);	
	//HAL_UART_Transmit_DMA(&huart4,u8_Tx_Data,9);
	

  /* USER CODE END 2 */

  /* Infinite loop */
  /* USER CODE BEGIN WHILE */
	//Enc_mode(MODE_X1);
	u8_Tx_Data[2] = 0xFF;
	//HAL_UART_Transmit_DMA(&huart4,u8_Tx_Data,402);
  while (1)
  {
    /* USER CODE END WHILE */
	
    /* USER CODE BEGIN 3 */
  }
  /* USER CODE END 3 */
}

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
/* USER CODE BEGIN 4 */
// TIM1 interup 0.005s
void HAL_TIM_PeriodElapsedCallback(TIM_HandleTypeDef *htim)
{
	if (htim -> Instance == TIM1){
	
	
	//enc_cnt =1000;
	if (mode == MODE_P)
	{
	enc_cnt  = __HAL_TIM_GetCounter(&htim2);
	e = s_enc_cnt - enc_cnt;

	static float u=0,u1 = 0 ,e1 = 0,e2 =0;
	u= u1 + Kp*(e-e1) + Ki*Ts*(e+e1)/2 + Kd*(e-2*e1+e2)/Ts;
	pid = u;
	if (u -pid>0.5) pid++;

	if (pid > x){
	pid = x;
	}
	else if (pid < -x){
	pid =-x;
	}
	e2= e1;
	e1 = e;
	u1=pid;
	if (pid >=0){
		__HAL_TIM_SetCompare(&htim8,TIM_CHANNEL_1, pid);
		HAL_GPIO_WritePin(GPIOC,GPIO_PIN_8,0);
		HAL_GPIO_WritePin(GPIOC,GPIO_PIN_9,1);
	}
	else{
		__HAL_TIM_SetCompare(&htim8,TIM_CHANNEL_1, -pid);
		HAL_GPIO_WritePin(GPIOC,GPIO_PIN_8,1);
		HAL_GPIO_WritePin(GPIOC,GPIO_PIN_9,0);
	}
	
		u8_Tx_Data[0] = enc_cnt>>8;
		u8_Tx_Data[1] = enc_cnt;
		u8_Tx_Data[2] = 0xFF;
	
	HAL_UART_Transmit_DMA(&huart4,u8_Tx_Data,3);
	}
		else 
	{
		enc_cnt_pre = enc_cnt;
		enc_cnt = __HAL_TIM_GetCounter(&htim2);
		pulse1 = enc_cnt - enc_cnt_pre;
			if ( pulse1>6300)
			{
				pulse1 = pulse1- 65536;
			}
			if (pulse1 < -6300)
			{
				pulse1 = pulse1+ 65536;
			}
			rate = pulse1*3000/374;
		if (s_rate !=0)
		{
			
			/* Compute PID Output for mortor1*/
			int e1 = s_rate -rate;
			static float u1_1 = 0 , u1 =0,e1_1 = 0,e2_1 =0;
			u1= u1_1 + Kp*(e1-e1_1) + Ki*Ts*(e1_1+e1)/2 + Kd*(e1-2*e1_1+e2_1)/Ts;
			pid1 = u1;
			if (u1 -pid1>0.5) pid1++;
			
			e2_1 = e1_1;
			e1_1 = e1;
			u1_1=pid1;
			
			
			if (pid1 >= 0)
			{
			if (pid1 > 999) pid1 =999;
			__HAL_TIM_SetCompare(&htim8,TIM_CHANNEL_1,pid1);
			HAL_GPIO_WritePin(GPIOC,GPIO_PIN_8,0);
			HAL_GPIO_WritePin(GPIOC,GPIO_PIN_9,1);	
			}
			else
			{
			if (pid1 < - 999) pid1 = - 999;
			__HAL_TIM_SetCompare(&htim8,TIM_CHANNEL_1, - pid1);
			HAL_GPIO_WritePin(GPIOC,GPIO_PIN_8,1);
			HAL_GPIO_WritePin(GPIOC,GPIO_PIN_9,0);
			}
		}
		else  /* Stop motor 1*/
		{
			HAL_GPIO_WritePin(GPIOC,GPIO_PIN_8,0);
			HAL_GPIO_WritePin(GPIOC,GPIO_PIN_9,0);
		}
		u8_Tx_Data[0] = rate>>8;
		u8_Tx_Data[1] = rate;
		u8_Tx_Data[2] = 0xFE;
	
		HAL_UART_Transmit_DMA(&huart4,u8_Tx_Data,3);
	}
	}

}
// UART4 RX_interup
void HAL_UART_RxCpltCallback(UART_HandleTypeDef *huart){
	if (u8_Rx_Data[5] != '#' ){
		//  Error
	}
	else{
	  char* ptr ;
		
		switch (u8_Rx_Data[0]){
			case('P') :
				// update KP
			  for (int i =0; i < 4 ; i++)
				{
					ptr = (char*)(&Kp);
					*(ptr+i) =  u8_Rx_Data[i+1];
				}
				break ;
			case ('I'):
				// update Ki
			for (int i =0; i < 4 ; i++)
				{
					ptr = (char*)(&Ki);
					*(ptr+i) =  u8_Rx_Data[i+1];
				}
				break ;
			case ('D'):
				// Update Kd
			for (int i =0; i < 4 ; i++)
				{
					ptr = (char*)(&Kd);
					*(ptr+i) =  u8_Rx_Data[i+1];
				}
				HAL_TIM_Base_Start_IT(&htim1);
				break ;
			case ('S'):
				if ( u8_Rx_Data[4] == 'P')
				{
				if (mode != MODE_P){
				Enc_mode(!status);	
				mode =  MODE_P;}
				ptr = (char*)(&s_enc_cnt);
				*ptr = u8_Rx_Data[1];
				*(ptr+1) = u8_Rx_Data[2];
					
				if (u8_Rx_Data[3] == '1')
				{
					Enc_mode(MODE_X1);
				}
				else if (u8_Rx_Data[3] =='4')
				{
					Enc_mode(MODE_X4);
				}
			}
				else if ( u8_Rx_Data[4] == 'V'){
				mode = MODE_V;
				ptr = (char*)(&s_rate);
				*ptr = u8_Rx_Data[1];
				*(ptr+1) = u8_Rx_Data[2];
				}
				break ;	
			default:
				//Stop
				HAL_TIM_Base_Stop_IT(&htim1);
				__HAL_TIM_SetCompare(&htim8,TIM_CHANNEL_1, 0);
		}
	}
}
// Change mode encoder
void Enc_mode(uint8_t mode){
	TIM_Encoder_InitTypeDef sConfig = {0};
	if (mode != status){
	if (mode){
	sConfig.EncoderMode = TIM_ENCODERMODE_TI12;
	htim2.Init.Prescaler = 0;
	}
	else{
	sConfig.EncoderMode = TIM_ENCODERMODE_TI1;
	htim2.Init.Prescaler = 2;
	}
	htim2.Instance = TIM2;
  
  htim2.Init.CounterMode = TIM_COUNTERMODE_UP;
  htim2.Init.Period = 0xFFFFFFFF; // 65535
  htim2.Init.ClockDivision = TIM_CLOCKDIVISION_DIV1;
  htim2.Init.AutoReloadPreload = TIM_AUTORELOAD_PRELOAD_DISABLE;
  sConfig.IC1Polarity = TIM_ICPOLARITY_RISING;
  sConfig.IC1Selection = TIM_ICSELECTION_DIRECTTI;
  sConfig.IC1Prescaler = TIM_ICPSC_DIV1;
  sConfig.IC1Filter = 0;
  sConfig.IC2Polarity = TIM_ICPOLARITY_RISING;
  sConfig.IC2Selection = TIM_ICSELECTION_DIRECTTI;
  sConfig.IC2Prescaler = TIM_ICPSC_DIV1;
  sConfig.IC2Filter = 0;
	HAL_TIM_Encoder_Stop(&htim2,TIM_CHANNEL_1|TIM_CHANNEL_2);
	HAL_TIM_Encoder_DeInit(&htim2);
	HAL_TIM_Encoder_Init(&htim2,&sConfig);
	HAL_TIM_Encoder_Start(&htim2,TIM_CHANNEL_1|TIM_CHANNEL_2);
	status =mode;
	}
}
/* USER CODE END 4 */
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
