Hau381/DC_Motor_Speed_And_Position_Control/Stm32F4_Speed_And_Position_Control/F4_Position_control.ioc

Mcu.UserName=STM32F407VGTx
PA0-WKUP.Signal=S_TIM2_CH1_ETR
PA1.Signal=S_TIM2_CH2
PC10.Signal=UART4_TX
PC11.Signal=UART4_RX
PC6.Signal=S_TIM8_CH1
PC8.Signal=GPIO_Output
PC9.Signal=GPIO_Output
PH0-OSC_IN.Signal=RCC_OSC_IN
PH1-OSC_OUT.Signal=RCC_OSC_OUT
