Hau381/DC_Motor_Speed_And_Position_Control/(notices)

Notices in the files:
Stm32F4_Speed_And_Position_Control/Core/Src/main.c:
Copyright (c) 2022 STMicroelectronics.
All rights reserved.
This software is licensed under terms that can be found in the LICENSE file
